mprosk/mtg_life_counter/datasheets/arduino-nano-pinout.jpg

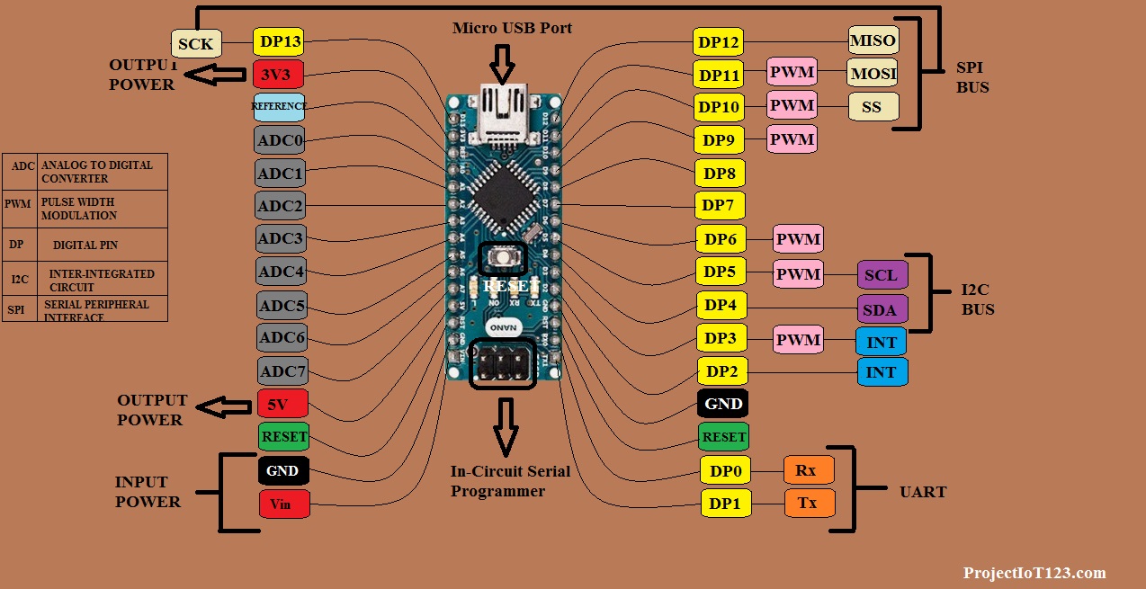
datasheets/arduino-nano-pinout.jpg
