mprosk/mtg_life_counter/datasheets/display_pinout.png

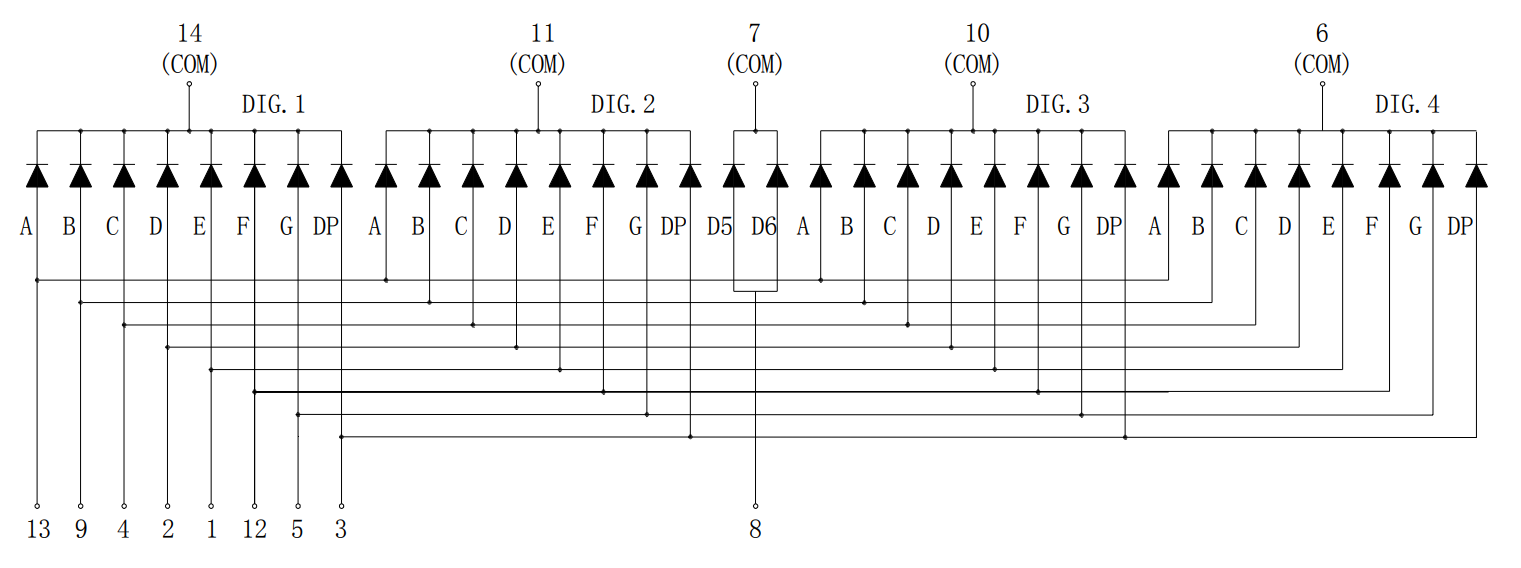
datasheets/display_pinout.png
