mprosk/mtg_life_counter/datasheets/pinout_smd.PNG

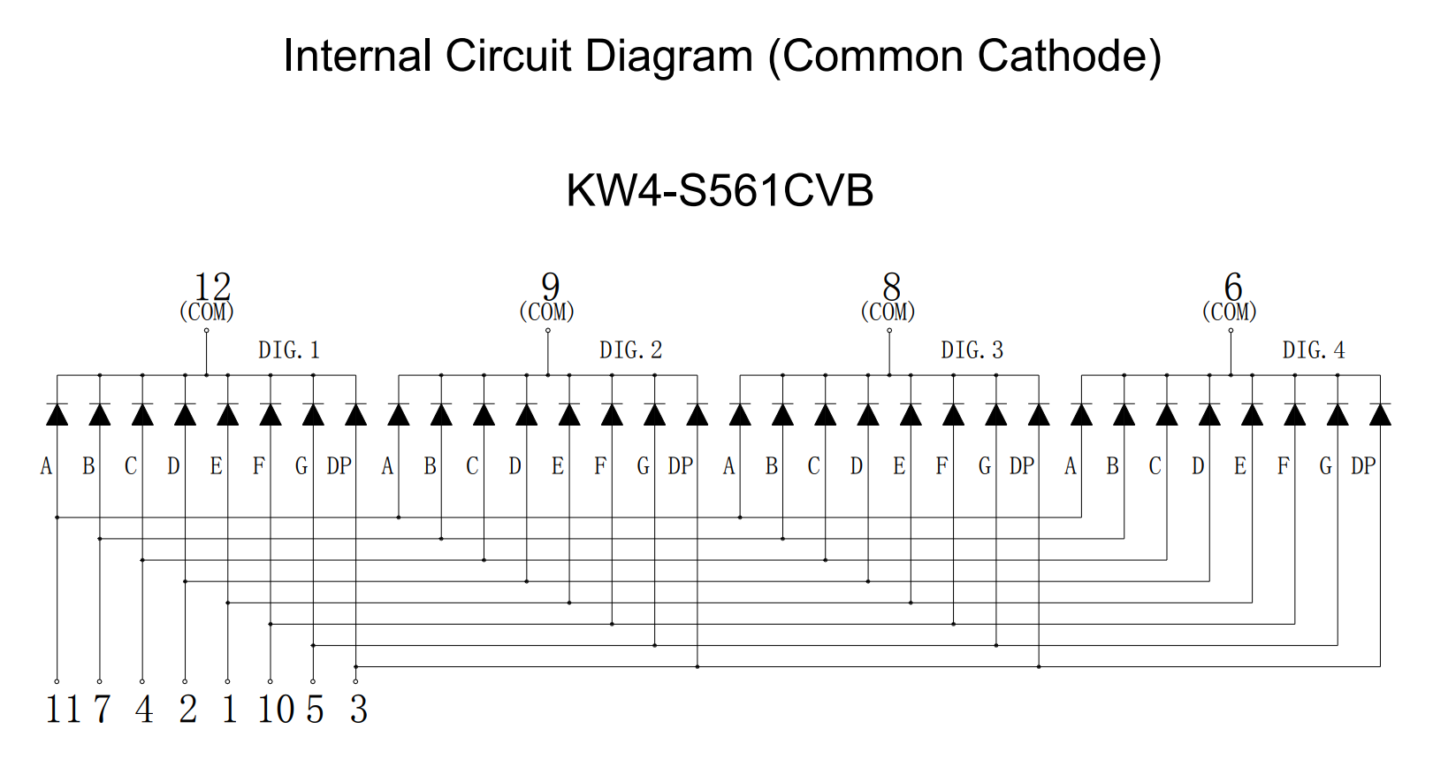
datasheets/pinout_smd.PNG
