mprosk/mtg_life_counter/datasheets/pinout_tht.PNG

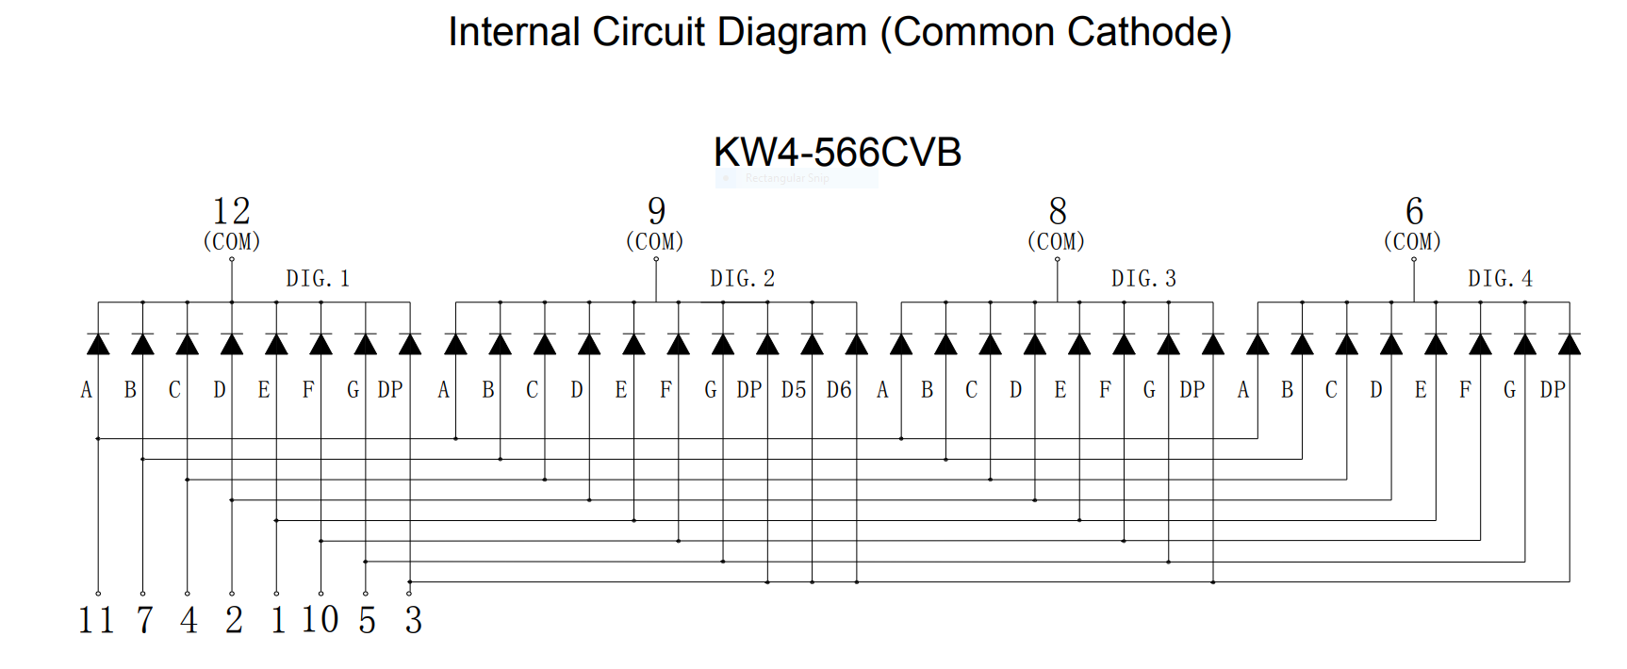
datasheets/pinout_tht.PNG
