mprosk/mtg_life_counter/datasheets/usbc/4907_C15777 datasheet.jpg

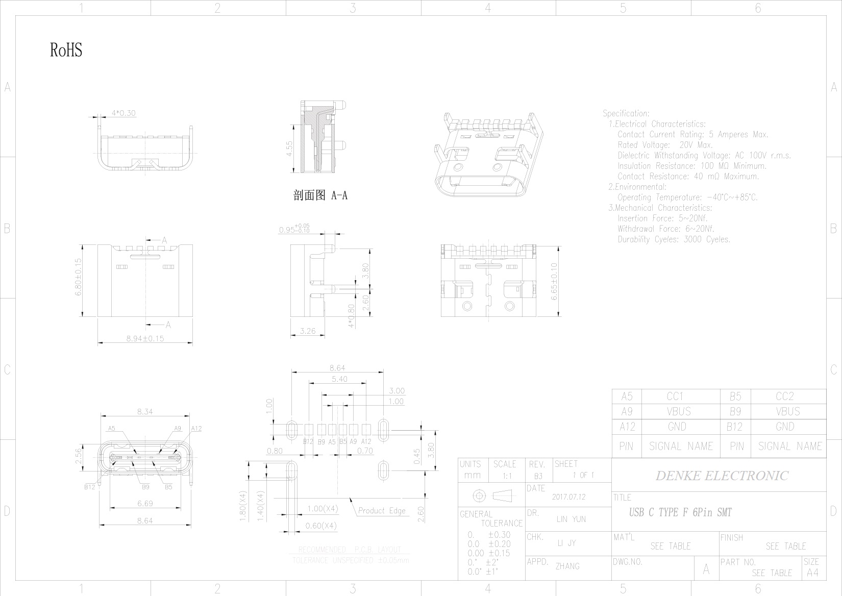
datasheets/usbc/4907_C15777 datasheet.jpg
