mprosk/mtg_life_counter/datasheets/usbc/4907_frontdiagram.png

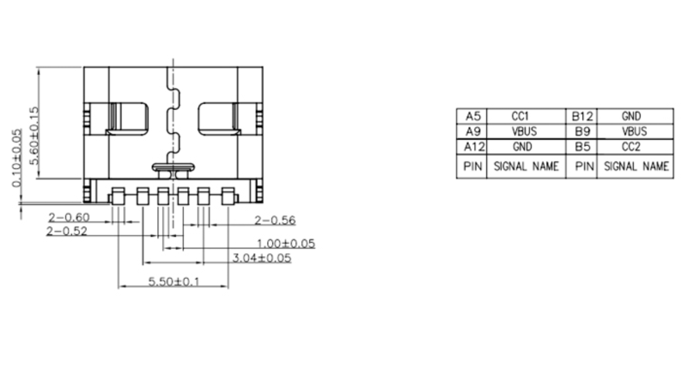
datasheets/usbc/4907_frontdiagram.png
