mprosk/mtg_life_counter/datasheets/usbc/4907_overall_diagram.png

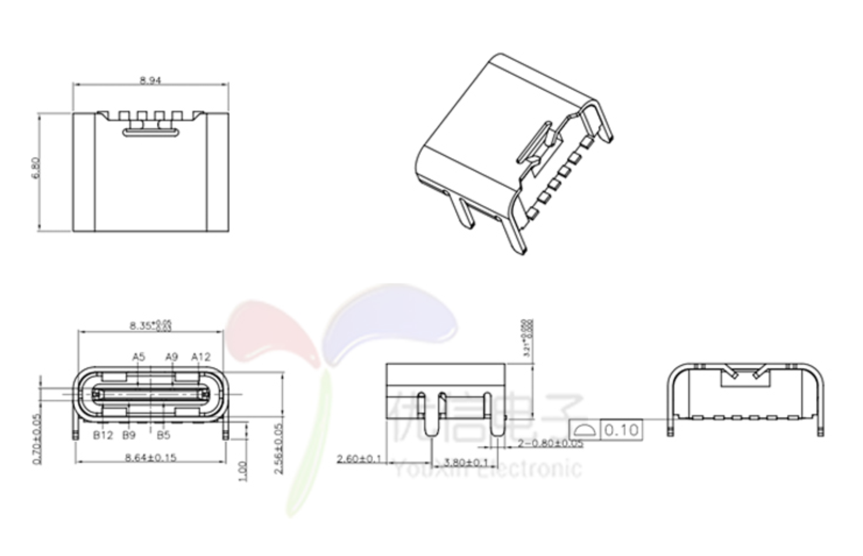
datasheets/usbc/4907_overall_diagram.png
