mprosk/mtg_life_counter/datasheets/usbc/4907_pinout.png

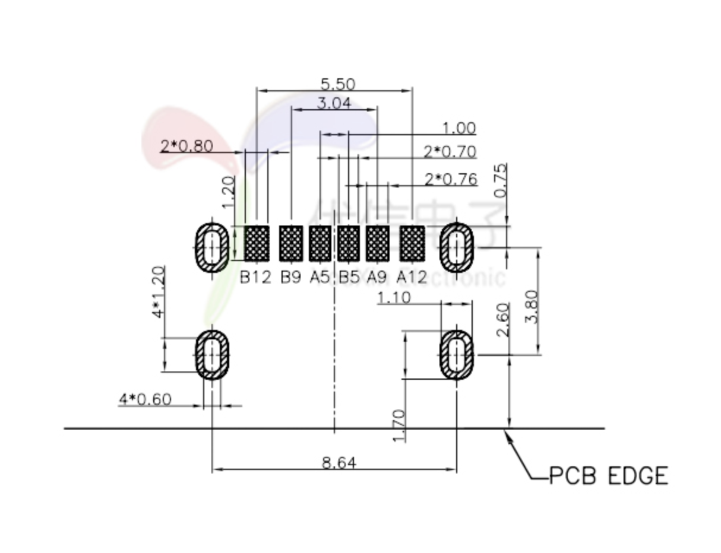
datasheets/usbc/4907_pinout.png
