mprosk/mtg_life_counter/img/counter.jpg

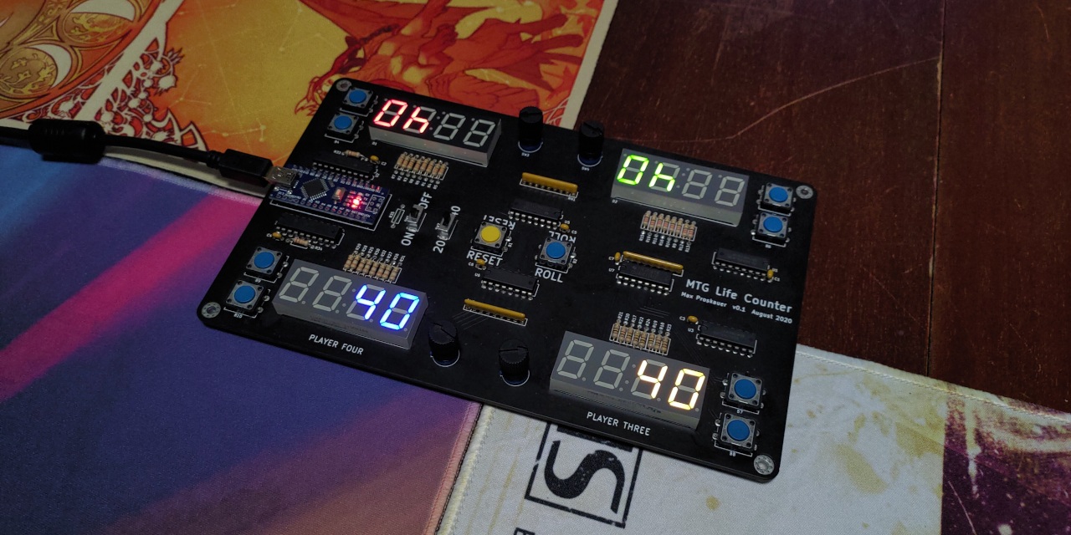
img/counter.jpg
