mprosk/mtg_life_counter/(threads)

Thread 3 (2024-04-06):

Which version to choose?

Dunrar, 2024-04-06:
Hi, very cool project! A friend and I are thinking about building this. Is the list of TODOs for version 2 up-to-date? And if so, does the TODO beneath "Selecting Display Mode" mean that this is not currently possible? Thanks!

mprosk, 2024-04-07:
Hi Dunrar! Thanks for your interest in this project! The TODOs for version 2 are all relating to the software, the hardware is stable and up to date. I'll hopefully have some time in about 2 weeks to finish out those sw changes once some other stuff on my backlog is complete.

The TODO in the section about selecting display mode is just a to-do for the instruction writeup itself, this feature is in place (although needs to get changed as described in the sw todo section). The firmware that's in `main` now will totally work, it just has janky controls (press and hold the encoder while rotating to change display modes, which will be changed to just clicking the encoder button once to cycle through)

The main differences between Version 1 and Version 2 is that version 1 is entirely through-hole while V2 is mostly surface mount, and therefore a bit smaller. Version 2 also uses rotary encoders whereas V1 used buttons and rotary switches. I added a photo of each to the readme so you can see the difference.

Lmk if you have any other questions or need help with assembly or anything like that. Also, out of curiosity, how did you first encounter this project?

Dunrar, 2024-04-24:
Hi @mprosk, sorry for the late answer, I missed your reply.

Thank you, no further questions for now. A friend and I will get started as soon as he finds the time, maybe we'll have questions then.

He also found the repository, a while back I gave him an Arduino as a present. We play Commander from time to time and I guess he must have found it via Google (not a software guy, so I doubt he searched GitHub directly).

mprosk, 2024-04-24:
Nice!
