mprosk/mtg_life_counter/schematic.pdf

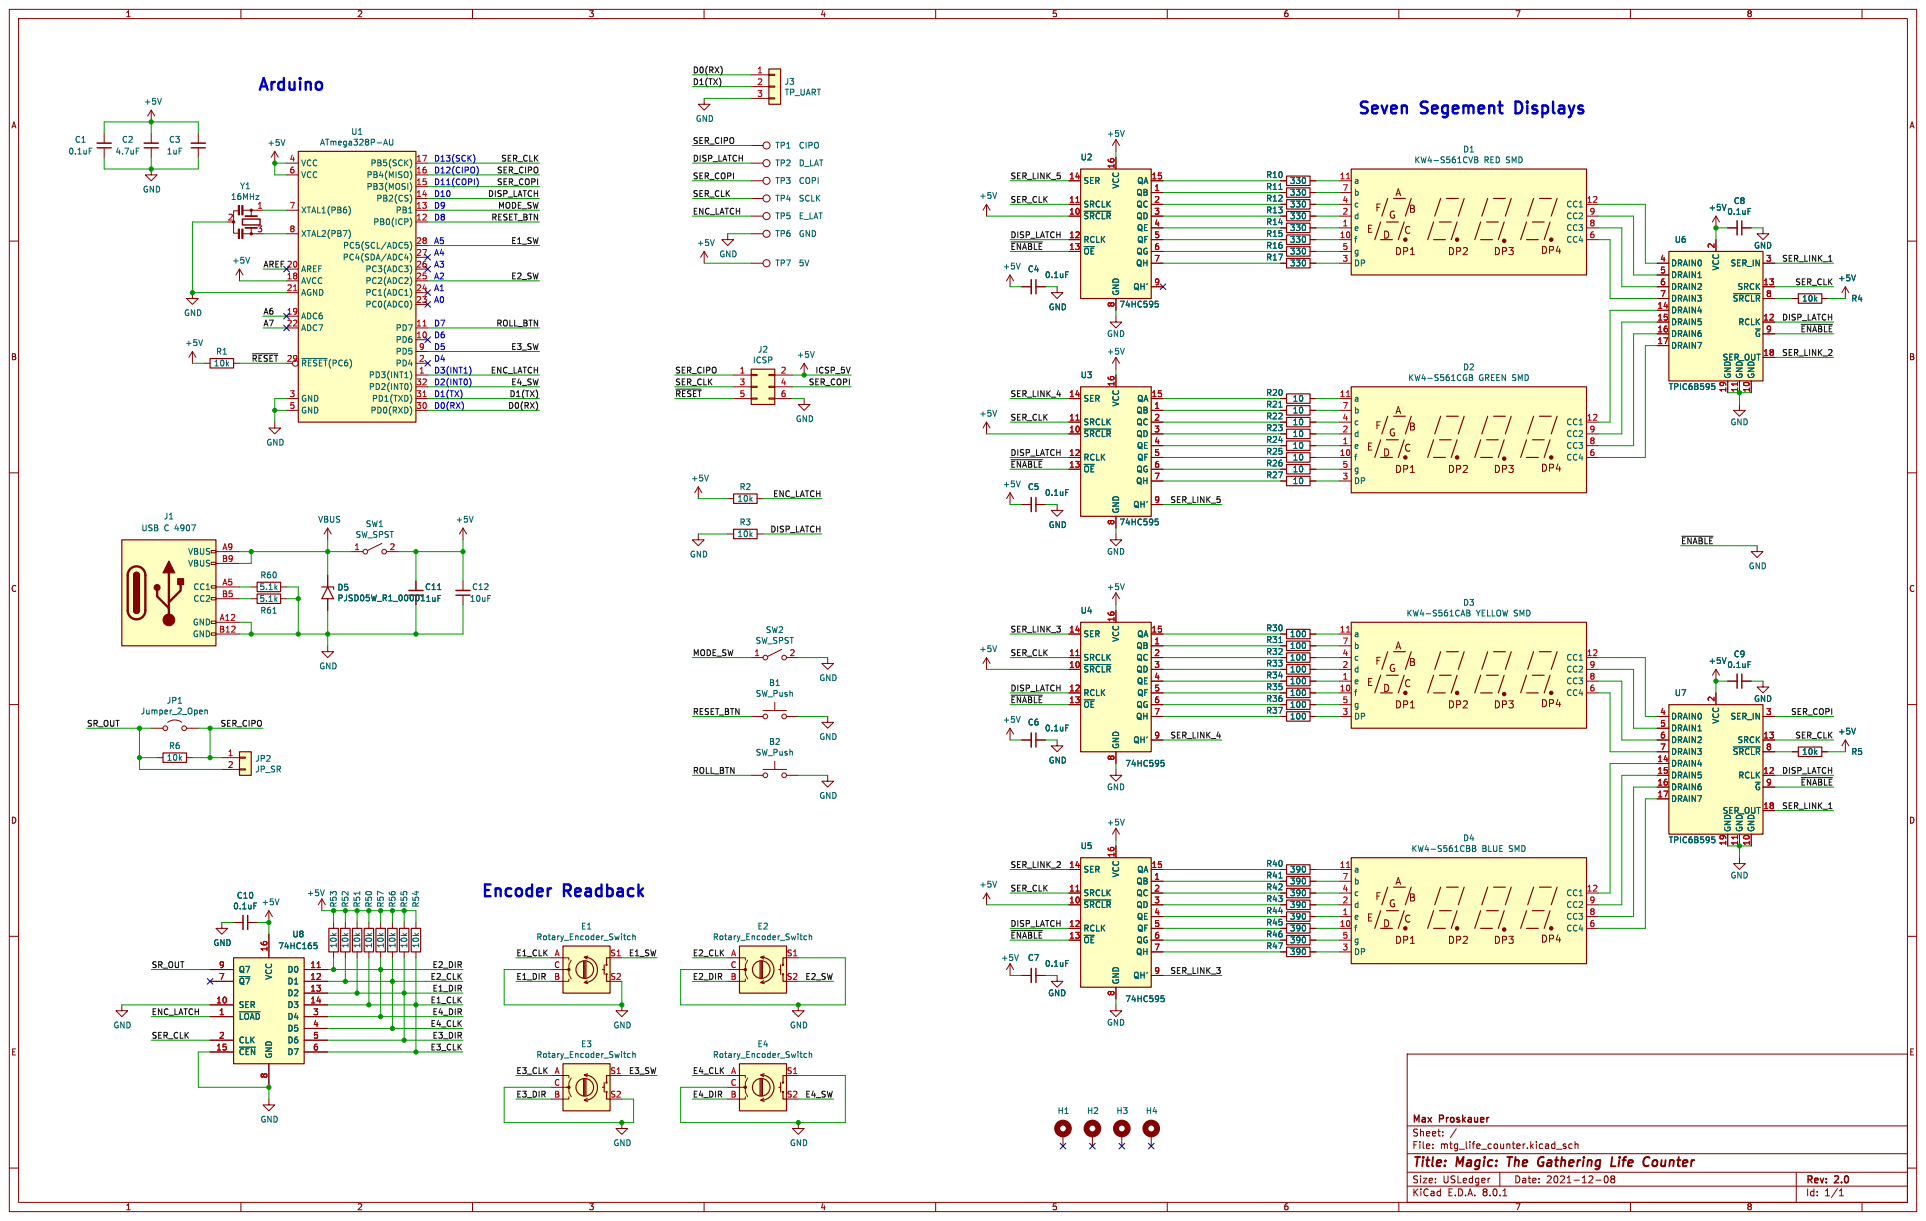
[picture p12: page 1]
