mprosk/mtg_life_counter/pcb/mtg_life_counter.kicad_pcb

## KiCad design pcb/mtg_life_counter.kicad_pcb (2024-03-22)

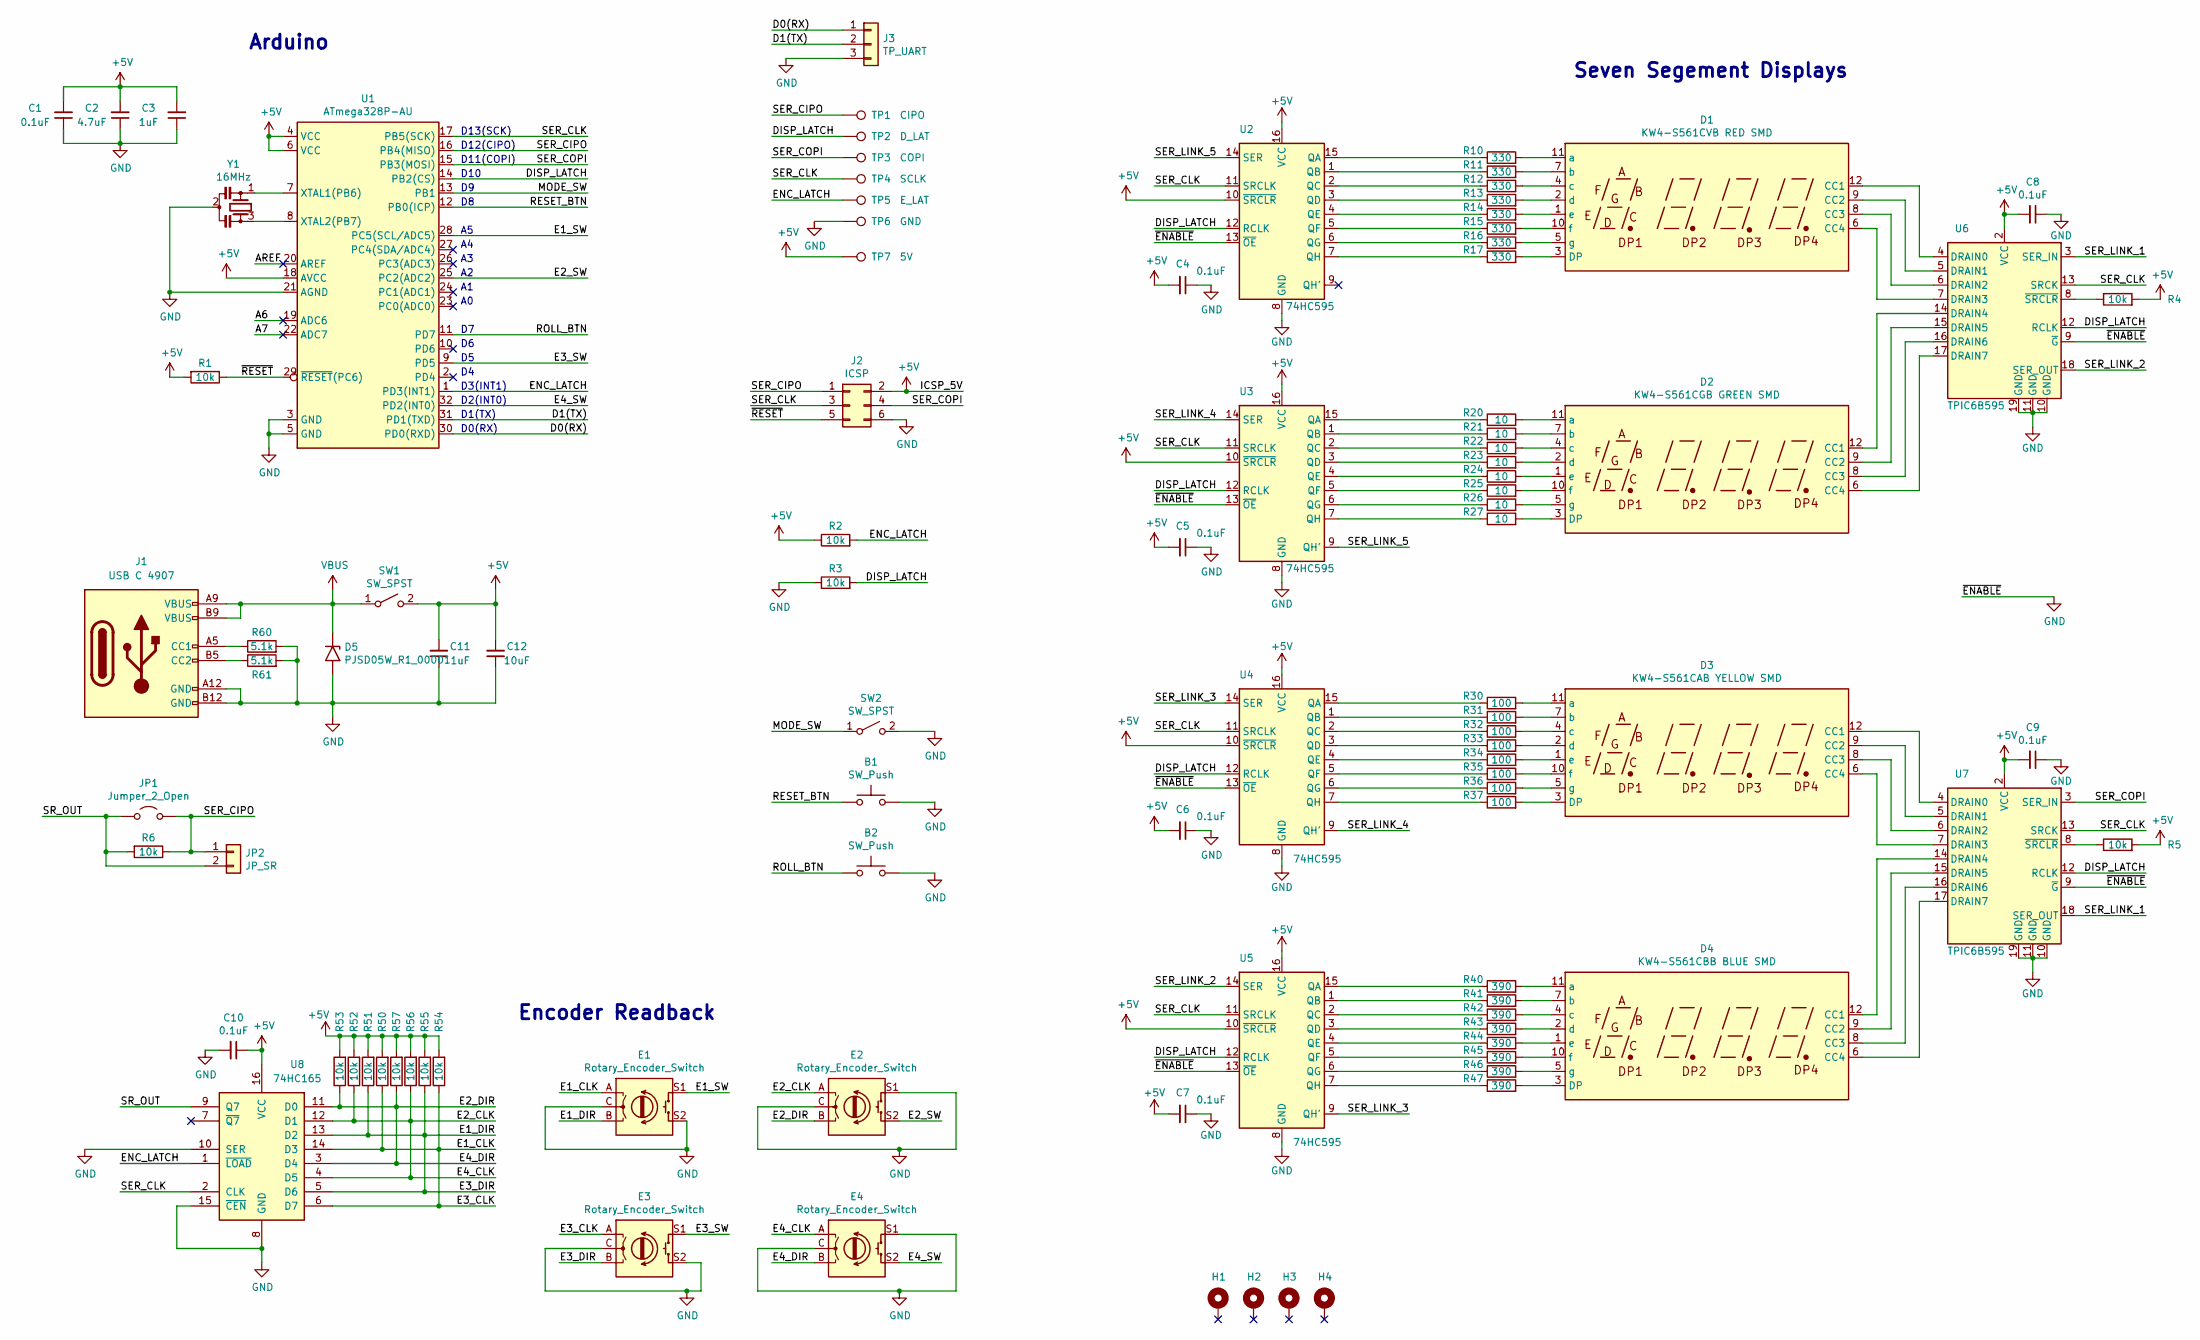
[picture p13: schematic mtg_life_counter.kicad_sch, Magic: The Gathering Life Counter]

Parts:
B1, B2: SW_Push; B3F_12mm
C1, C4, C5, C6, C7, C8, C9, C10: 0.1uF; C_0805_2012Metric_Pad1.15x1.40mm_HandSolder
C2: 4.7uF; C_0805_2012Metric_Pad1.15x1.40mm_HandSolder
C3, C11: 1uF; C_0805_2012Metric_Pad1.15x1.40mm_HandSolder
C12: 10uF; C_0805_2012Metric_Pad1.15x1.40mm_HandSolder
D1: KW4-S561CVB RED SMD; KW4-S561xxB_SMD
D2: KW4-S561CGB GREEN SMD; KW4-S561xxB_SMD
D3: KW4-S561CAB YELLOW SMD; KW4-S561xxB_SMD
D4: KW4-S561CBB BLUE SMD; KW4-S561xxB_SMD
D5: PJSD05W_R1_00001; D_SOD-323_HandSoldering
E1, E2, E3, E4: Rotary_Encoder_Switch; TT_EN11-HSB
H1, H2, H3, H4: MountingHole_Pad; MountingHole_3.2mm_M3_Pad_Via
J1: USB C 4907; 4907_USB_C_PowerOnly
J2: ICSP; Tag-Connect_TC2030-IDC-NL_2x03_P1.27mm_Vertical
J3: TP_UART; TP_Edge_3
JP1: Jumper_2_Open; SolderJumper-2_P1.3mm_Open_TrianglePad1.0x1.5mm
JP2: JP_SR; TP_Edge_2
R1, R2, R3, R4, R5, R6, R50, R51, R52, R53, R54, R55, R56, R57: 10k; R_0805_2012Metric_Pad1.15x1.40mm_HandSolder
R10, R11, R12, R13, R14, R15, R16, R17: 330; R_0805_2012Metric_Pad1.15x1.40mm_HandSolder
R20, R21, R22, R23, R24, R25, R26, R27: 10; R_0805_2012Metric_Pad1.15x1.40mm_HandSolder
R30, R31, R32, R33, R34, R35, R36, R37: 100; R_0805_2012Metric_Pad1.15x1.40mm_HandSolder
R40, R41, R42, R43, R44, R45, R46, R47: 390; R_0805_2012Metric_Pad1.15x1.40mm_HandSolder
R60, R61: 5.1k; R_0805_2012Metric_Pad1.15x1.40mm_HandSolder
SW1, SW2: SW_SPST; SW_Slide_1P2T_CK_OS102011MS2Q
TP1: CIPO; TestPoint_Pad_D2.0mm
TP2: D_LAT; TestPoint_Pad_D2.0mm
TP3: COPI; TestPoint_Pad_D2.0mm
TP4: SCLK; TestPoint_Pad_D2.0mm
TP5: E_LAT; TestPoint_Pad_D2.0mm
TP6: GND; TestPoint_Pad_D2.0mm
TP7: 5V; TestPoint_Pad_D2.0mm
U1: ATmega328P-AU; TQFP-32_7x7mm_P0.8mm
U2, U3, U4, U5: 74HC595; SOIC-16_3.9x9.9mm_P1.27mm
U6, U7: TPIC6B595; SOIC-20W_7.5x12.8mm_P1.27mm
U8: 74HC165; SOIC-16_3.9x9.9mm_P1.27mm
Y1: 16MHz; Resonator_muRata_CSTLSxxxX-3Pin_W5.5mm_H3.0mm

Connections:
+5V: C1.2, C2.2, C3.2, C4.2, C5.2, C6.2, C7.2, C8.2, C9.2, C10.1, C11.2, C12.2, J2.2, R1.2, R2.1, R4.2, R5.2, R50.2, R51.2, R52.2, R53.2, R54.2, R55.2, R56.2, R57.2, SW1.2 (B), TP7.1, U1.4 (VCC), U1.6 (VCC), U1.18 (AVCC), U2.10 (~SRCLR), U2.16 (VCC), U3.10 (~SRCLR), U3.16 (VCC), U4.10 (~SRCLR), U4.16 (VCC), U5.10 (~SRCLR), U5.16 (VCC), U6.2 (VCC), U7.2 (VCC), U8.16 (VCC)
/A6: U1.19 (ADC6)
/A7: U1.22 (ADC7)
/AREF: U1.20 (AREF)
/D0(RX): J3.1, U1.30 (PD0(RXD))
/D1(TX): J3.2, U1.31 (PD1(TXD))
/DISP_LATCH: R3.2, TP2.1, U1.14 (PB2(CS)), U2.12 (RCLK), U3.12 (RCLK), U4.12 (RCLK), U5.12 (RCLK), U6.12 (RCLK), U7.12 (RCLK)
/E1_SW: E1.S1, U1.28 (PC5(SCL/ADC5))
/E2_SW: E2.S2, U1.25 (PC2(ADC2))
/E3_SW: E3.S1, U1.9 (PD5)
/E4_SW: E4.S2, U1.32 (PD2(INT0))
/ENC_LATCH: R2.2, TP5.1, U1.1 (PD3(INT1)), U8.1 (~LOAD)
/MODE_SW: SW2.1 (A), U1.13 (PB1)
/RESET_BTN: B1.1, U1.12 (PB0(ICP))
/ROLL_BTN: B2.1, U1.11 (PD7)
/SER_CIPO: J2.1, JP1.2 (B), JP2.1, R6.1, TP1.1, U1.16 (PB4(MISO))
/SER_CLK: J2.3, TP4.1, U1.17 (PB5(SCK)), U2.11 (SRCLK), U3.11 (SRCLK), U4.11 (SRCLK), U5.11 (SRCLK), U6.13 (SRCK), U7.13 (SRCK), U8.2 (CLK)
/SER_COPI: J2.4, TP3.1, U1.15 (PB3(MOSI)), U7.3 (SER_IN)
/SER_LINK_1: U6.3 (SER_IN), U7.18 (SER_OUT)
/SER_LINK_2: U5.14 (SER), U6.18 (SER_OUT)
/SER_LINK_3: U4.14 (SER), U5.9 (QH')
/SER_LINK_4: U3.14 (SER), U4.9 (QH')
/SER_LINK_5: U2.14 (SER), U3.9 (QH')
/SR_OUT: JP1.1 (A), JP2.2, R6.2, U8.9 (Q7)
/~RESET: J2.5, R1.1, U1.29 (~RESET(PC6))
GND: B1.2, B2.2, C1.1, C2.1, C3.1, C4.1, C5.1, C6.1, C7.1, C8.1, C9.1, C10.2, C11.1, C12.1, D5.2 (A2), E1.C, E1.S2, E2.C, E2.S1, E3.C, E3.S2, E4.C, E4.S1, J1.A12 (GND), J1.B12 (GND), J2.6, J3.3, R3.1, R60.2, R61.2, SW2.2 (B), TP6.1, U1.3 (GND), U1.5 (GND), U1.21 (AGND), U2.8 (GND), U2.13 (~OE), U3.8 (GND), U3.13 (~OE), U4.8 (GND), U4.13 (~OE), U5.8 (GND), U5.13 (~OE), U6.1 (NC), U6.9 (~G), U6.10 (GND), U6.11 (GND), U6.19 (GND), U6.20 (NC), U7.1 (NC), U7.9 (~G), U7.10 (GND), U7.11 (GND), U7.19 (GND), U7.20 (NC), U8.8 (GND), U8.10 (SER), U8.15 (~CEN), Y1.2
unnamed: D1.1 (e), R14.2
unnamed: D1.2 (d), R13.2
unnamed: D1.3 (DP), R17.2
unnamed: D1.4 (c), R12.2
unnamed: D1.5 (g), R16.2
unnamed: D1.6 (CC4), U6.7 (DRAIN3)
unnamed: D1.7 (b), R11.2
unnamed: D1.8 (CC3), U6.6 (DRAIN2)
unnamed: D1.9 (CC2), U6.5 (DRAIN1)
unnamed: D1.10 (f), R15.2
unnamed: D1.11 (a), R10.2
unnamed: D1.12 (CC1), U6.4 (DRAIN0)
unnamed: D2.1 (e), R24.2
unnamed: D2.2 (d), R23.2
unnamed: D2.3 (DP), R27.2
unnamed: D2.4 (c), R22.2
unnamed: D2.5 (g), R26.2
unnamed: D2.6 (CC4), U6.17 (DRAIN7)
unnamed: D2.7 (b), R21.2
unnamed: D2.8 (CC3), U6.16 (DRAIN6)
unnamed: D2.9 (CC2), U6.15 (DRAIN5)
unnamed: D2.10 (f), R25.2
unnamed: D2.11 (a), R20.2
unnamed: D2.12 (CC1), U6.14 (DRAIN4)
unnamed: D3.1 (e), R34.2
unnamed: D3.2 (d), R33.2
unnamed: D3.3 (DP), R37.2
unnamed: D3.4 (c), R32.2
unnamed: D3.5 (g), R36.2
unnamed: D3.6 (CC4), U7.7 (DRAIN3)
unnamed: D3.7 (b), R31.2
unnamed: D3.8 (CC3), U7.6 (DRAIN2)
unnamed: D3.9 (CC2), U7.5 (DRAIN1)
unnamed: D3.10 (f), R35.2
unnamed: D3.11 (a), R30.2
unnamed: D3.12 (CC1), U7.4 (DRAIN0)
unnamed: D4.1 (e), R44.2
unnamed: D4.2 (d), R43.2
unnamed: D4.3 (DP), R47.2
unnamed: D4.4 (c), R42.2
unnamed: D4.5 (g), R46.2
unnamed: D4.6 (CC4), U7.17 (DRAIN7)
unnamed: D4.7 (b), R41.2
unnamed: D4.8 (CC3), U7.16 (DRAIN6)
unnamed: D4.9 (CC2), U7.15 (DRAIN5)
unnamed: D4.10 (f), R45.2
unnamed: D4.11 (a), R40.2
unnamed: D4.12 (CC1), U7.14 (DRAIN4)
unnamed: J1.A5 (CC1), R60.1
unnamed: J1.B5 (CC2), R61.1
unnamed: R4.1, U6.8 (~SRCLR)
unnamed: R5.1, U7.8 (~SRCLR)
unnamed: R10.1, U2.15 (QA)
unnamed: R11.1, U2.1 (QB)
unnamed: R12.1, U2.2 (QC)
unnamed: R13.1, U2.3 (QD)
unnamed: R14.1, U2.4 (QE)
unnamed: R15.1, U2.5 (QF)
unnamed: R16.1, U2.6 (QG)
unnamed: R17.1, U2.7 (QH)
unnamed: R20.1, U3.15 (QA)
unnamed: R21.1, U3.1 (QB)
unnamed: R22.1, U3.2 (QC)
unnamed: R23.1, U3.3 (QD)
unnamed: R24.1, U3.4 (QE)
unnamed: R25.1, U3.5 (QF)
unnamed: R26.1, U3.6 (QG)
unnamed: R27.1, U3.7 (QH)
unnamed: R30.1, U4.15 (QA)
unnamed: R31.1, U4.1 (QB)
unnamed: R32.1, U4.2 (QC)
unnamed: R33.1, U4.3 (QD)
unnamed: R34.1, U4.4 (QE)
unnamed: R35.1, U4.5 (QF)
unnamed: R36.1, U4.6 (QG)
unnamed: R37.1, U4.7 (QH)
unnamed: R40.1, U5.15 (QA)
unnamed: R41.1, U5.1 (QB)
unnamed: R42.1, U5.2 (QC)
unnamed: R43.1, U5.3 (QD)
unnamed: R44.1, U5.4 (QE)
unnamed: R45.1, U5.5 (QF)
unnamed: R46.1, U5.6 (QG)
unnamed: R47.1, U5.7 (QH)
unnamed: U1.7 (XTAL1(PB6)), Y1.1
unnamed: U1.8 (XTAL2(PB7)), Y1.3
VBUS: D5.1 (A1), J1.A9 (VBUS), J1.B9 (VBUS), SW1.1 (A)

Notes on the sheet:
D0(RX)
D2(INT0)
Seven Segement Displays
Encoder Readback
D12(CIPO)
Arduino
D3(INT1)
D1(TX)
D10
D13(SCK)
D11(COPI)

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
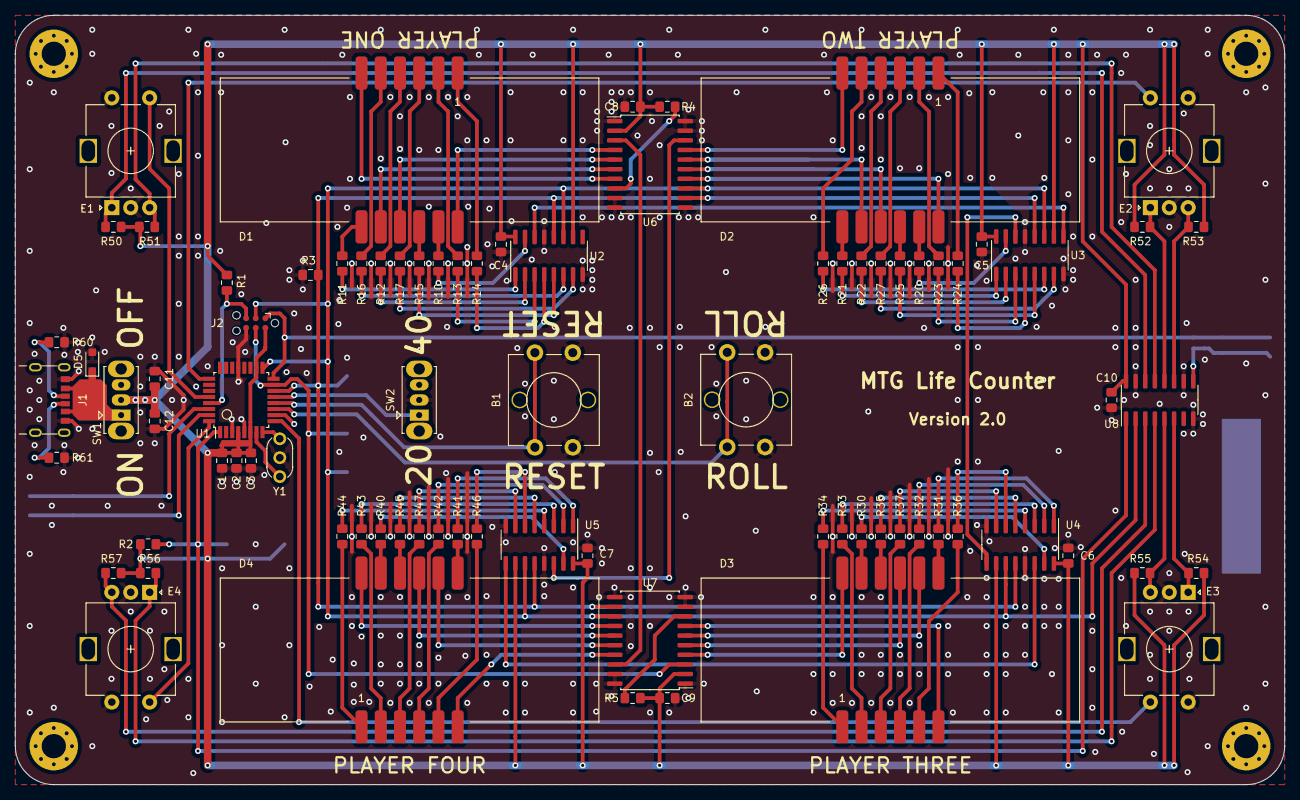
[picture p14: board mtg_life_counter.kicad_pcb from above]

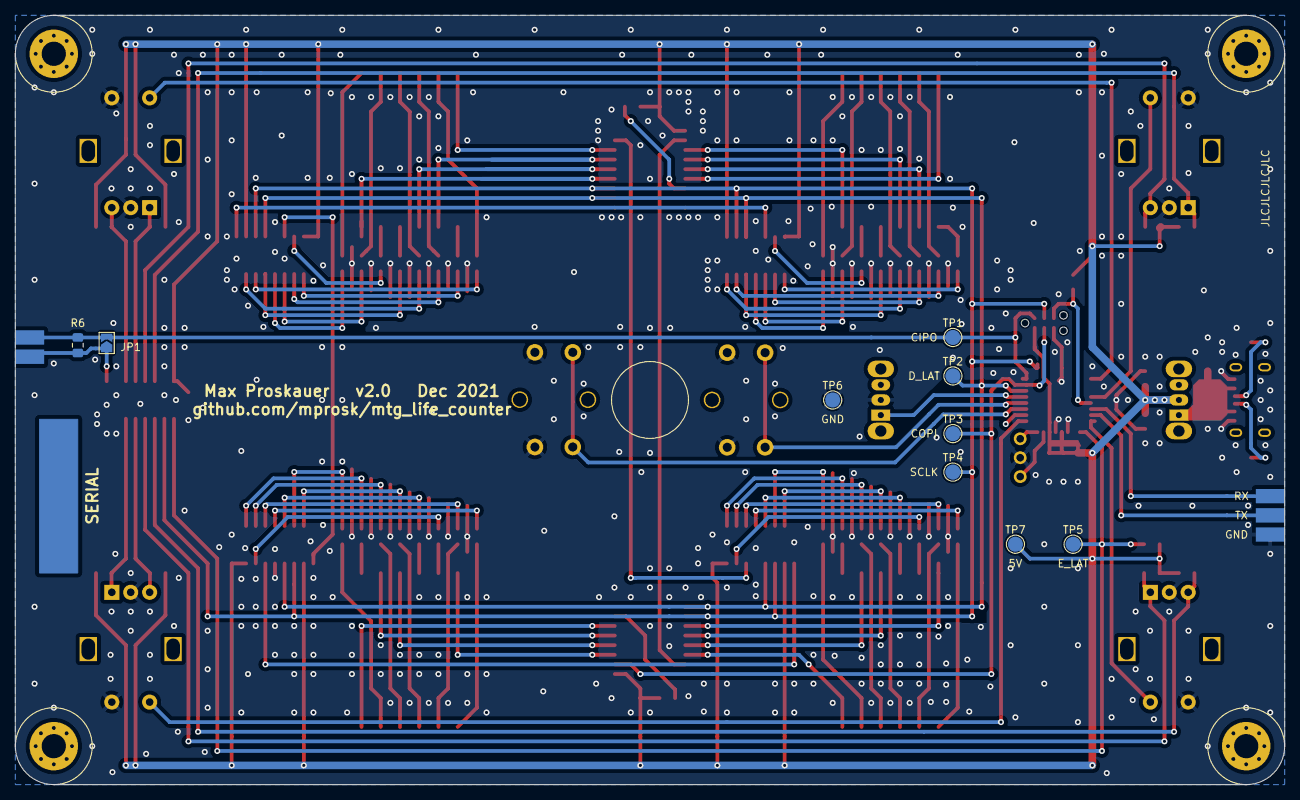
[picture p15: board mtg_life_counter.kicad_pcb from below]

Board: 2 copper layers, 167.6 x 101.6 mm, 98 parts (11 on the bottom side), 118 nets.
