mprosk/mtg_life_counter/(commit log)

2020-08-04 initial schematic sketch
    [mtg_life_counter.kicad_pcb, mtg_life_counter.sch]
2020-08-05 Get schematic more complete
    [mtg_life_counter.sch]
2020-08-07 Complete PCB layout
    [b3f_12mm.skp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]
2020-08-07 Fix TPIC pinout
    [mtg_life_counter-B_Cu.gbr, mtg_life_counter-B_Mask.gbr, mtg_life_counter-B_Paste.gbr, mtg_life_counter-B_SilkS.gbr, mtg_life_counter-Edge_Cuts.gbr, mtg_life_counter-F_Cu.gbr, mtg_life_counter-F_Mask.gbr, mtg_life_counter-F_Paste.gbr]
2020-08-08 Complete PCB layout. Purchased version
    [mtg_life_counter-B_Cu.gbr, mtg_life_counter-B_Mask.gbr, mtg_life_counter-B_Paste.gbr, mtg_life_counter-B_SilkS.gbr, mtg_life_counter-Edge_Cuts.gbr, mtg_life_counter-F_Cu.gbr, mtg_life_counter-F_Mask.gbr, mtg_life_counter-F_Paste.gbr]
2020-08-17 Rename PCB folder
    [b3f_12mm.skp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]
2020-08-17 Rename Arduino project
2020-08-18 Begin stubbing out display driver
2020-08-18 Fix A6 A7 digital mode bug (SCHEMATIC ONLY)
    [mtg_life_counter.sch]
2020-08-18 Complete switch and button sensing with hardware
2020-08-19 Update resistor values for displays. Remove power switch resistor
    [mtg_life_counter.sch]
2020-08-19 Achieve minimum viable product (4 independent counters, no cmdr damage)
    [timer.xlsx]
2020-08-21 Refactor roll into separate function
    [timer.xlsx]
2020-08-21 Add ability to reset individual counter by pressing both buttons at once
    [mtg_firmware.ino]
2020-08-21 Refactor button stuff, add text option to display
2020-08-21 Get commander damage display almost there
    [mtg_firmware.ino]
2020-08-22 Add commander damange tracking with the rotary switches
2020-08-22 Fix bug in rotary init
    [mtg_firmware.ino]
2020-08-23 Fix high current drain during sleep
    [display.cpp, display.h, mtg_firmware.ino]
2020-08-23 Actually fix standby current issue. Add core temp instrumentation
    [mtg_firmware.ino]
2020-08-24 Move core temperature to separate module
2020-08-24 Use 30 starting life if reset is held when mode switch is changed
    [mtg_firmware.ino]
2020-08-25 Update switches module to match style guide
2020-08-25 Cleanup switches
2020-08-25 Refactor switches module
2020-08-26 Add debouncing to the switch zero-state
2020-08-26 Fix timer rollover in roll module
    [roll.cpp]
2020-08-28 Remove printout from switches rotary read
2020-08-30 begin design plan for mini
    [mtg_life_counter.sch]
2020-08-31 Sketch out mini pcb
    [mtg_life_counter.kicad_pcb, mtg_life_counter.sch]
2020-09-01 copy in encoders sketch
2020-09-01 Continue updating schematic
    [mtg_life_counter.kicad_pcb, mtg_life_counter.sch]
2020-09-02 Continue work on mini PCB
    [mtg_life_counter.kicad_pcb, mtg_life_counter.sch]
2020-09-03 Continue work on mini version
    [mtg_life_counter.kicad_pcb, mtg_life_counter.sch]
2020-09-14 Tweak layout
    [mtg_life_counter.kicad_pcb, mtg_life_counter.sch]
2020-09-14 Mess w timer excel
    [timer.xlsx]
2020-12-31 complete electrical layout
    [mtg_life_counter.kicad_pcb, mtg_life_counter.sch]
2021-02-11 Switch to 74x165. Optimize pin assignments
    [mtg_life_counter.kicad_pcb, mtg_life_counter.sch]
2021-02-12 Finish routing
    [mtg_life_counter.kicad_pcb, mtg_life_counter.sch]
2021-02-12 Fill some zones
    [mtg_life_counter.kicad_pcb]
2021-02-12 Add comments from design review
    [issue_tracker.xlsx, mtg_life_counter.kicad_pcb, mtg_life_counter.sch]
2021-11-22 Switch to SMD 7segs
    [mtg_life_counter.kicad_pcb, mtg_life_counter.sch]
2021-11-23 Complete layout. Use new USB-C connector
    [mtg_life_counter.kicad_pcb, mtg_life_counter.sch]
2021-11-25 Tweak encoder footprint. Add more via stitching
    [mtg_life_counter-B_Cu.gbr, mtg_life_counter-B_Mask.gbr, mtg_life_counter-B_Paste.gbr, mtg_life_counter-B_SilkS.gbr, mtg_life_counter-Edge_Cuts.gbr, mtg_life_counter-F_Cu.gbr, mtg_life_counter-F_Mask.gbr, mtg_life_counter-F_Paste.gbr]
2021-11-25 Copy firmware changes from master
    [timer.xlsx]
2021-11-25 Begin updating firmware to match new hardware
    [mtg_life_counter.sch]
2021-11-26 Separate display and encoder latch lines
    [mtg_life_counter.kicad_pcb, mtg_life_counter.sch]
2021-11-29 Add protection diode. Finalize test points + jumpers
    [mtg_life_counter.kicad_pcb, mtg_life_counter.sch]
2021-12-08 Resolve design review issues
    [b3f_12mm.skp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]
2021-12-08 Add silkscreen outline to LED displays
    [mtg_life_counter.kicad_pcb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]
2021-12-08 Update date in schematics. Update PDF
    [mtg_life_counter.kicad_pcb, mtg_life_counter.sch]
2021-12-17 Start to remove old software implementation
    [timer.xlsx]
2021-12-21 Get display test working
    [timer.xlsx]
2021-12-24 Get basic functionality working
    [timer.xlsx]
2021-12-29 Get button detection working
2021-12-30 Sort of get display mode switching to work
2024-03-22 Update to KiCad 8 and clean up files
    [issue_tracker.xlsx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]
2024-04-07 Update README, fix Arduino.h includes
    [config.h, display.h, encoders.h, roll.h]
